start-jsk/telemba/README.md

Telemba
===================

**WARNING: This project is no longer maintained. You cannot make it work anymore without MUCH effort.**

Telemba is the world's cheapest telepresence robot. 

Telemba video (http://www.youtube.com/watch?v=4p75EE9H2MQ)

Telemba builds your Roomba and Android into a new communication
tool. If you have a Roomba and an Android tablet (or phone), Telemba
is definitely easiest and cheapest way to build your own tele-presence
robot.

Telemba is open-source and open-hardware project. It is designed as
anyone can modify it adding sensors and RC servo motors to control as
the video shows.

Please see the wiki page of telemba for how to make your own telemba.

[Telemba Wiki](https://github.com/start-jsk/telemba/wiki)

# LISENCE
* Mechanical CAD data is published under Creative Commons (BY-SA)
* Source code for PIC ADK is published under MIT License. Certain file is provided by Microchip corp.
* Sorrce code for Android app is published under ??? License (TBD).
