start-jsk/telemba/hangouts/img/connect-button.png

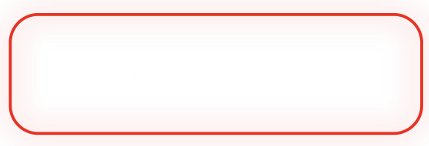
hangouts/img/connect-button.png
