start-jsk/telemba/hangouts/img/telemba_connect.png

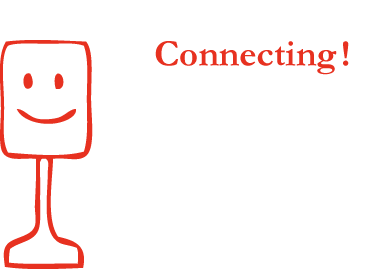
hangouts/img/telemba_connect.png
