start-jsk/telemba/hangouts/img/telemba_missing.png

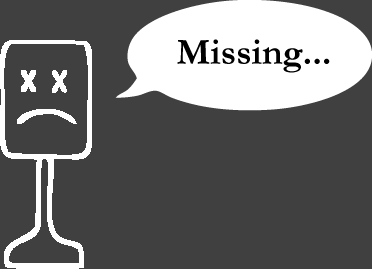
hangouts/img/telemba_missing.png
