start-jsk/telemba/hangouts/img/telemba_without_battery.png

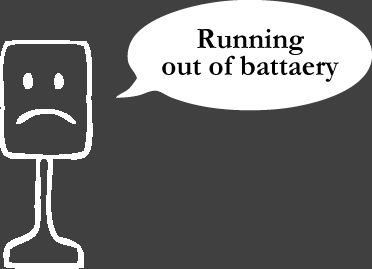
hangouts/img/telemba_without_battery.png
