start-jsk/telemba/mechanical/Telemba-012/Telemba-012_PartsList.pdf

Mechanical System | Telemba-012

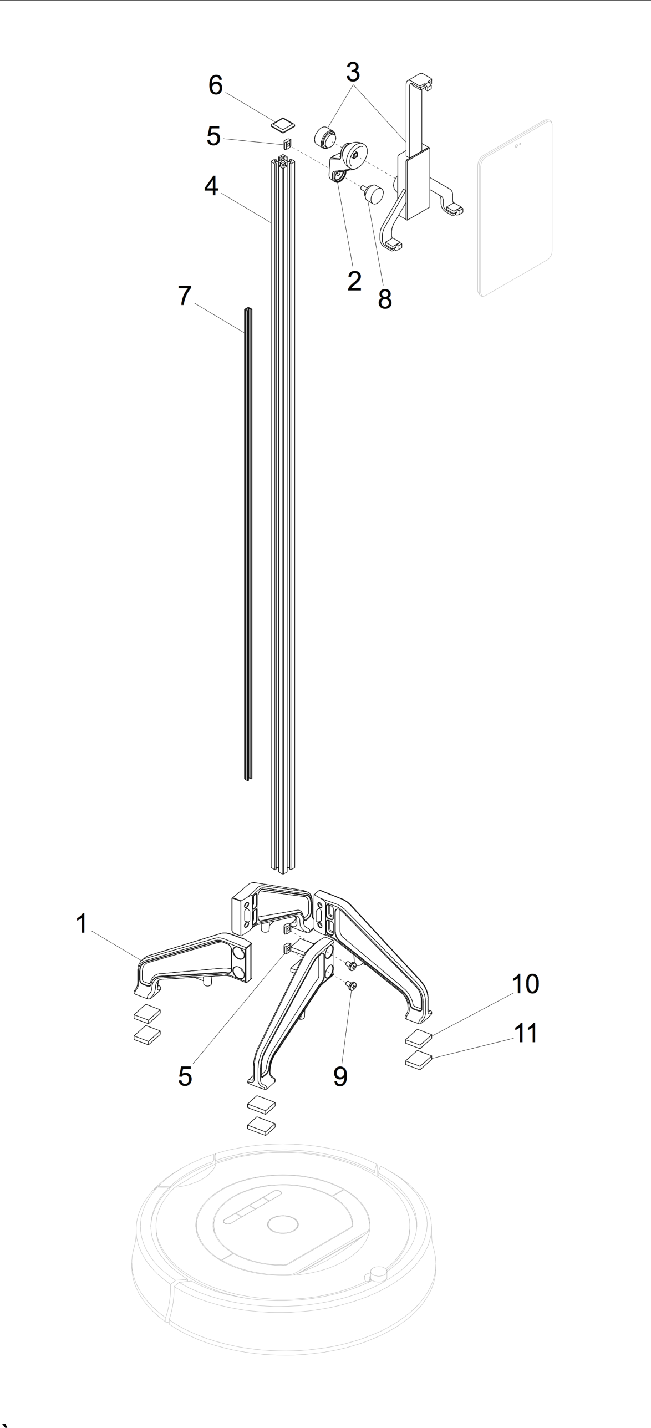
[picture p5: figure]

`

No. | Part Number | Part Name | Qty | Maker | Remarks
1 | 50000-TLMB-0000 | Leg, Base | 4 | | Telemba-012_3DPrinter.stl / igs
2 | 50001-TLMB-0000 | Bracket, Tablet Holder | 1 | | Telemba-012_3DPrinter.stl / igs
3 | | Holder, Tablet | 1
4 | SFF-204 L=1000 | Frame, Standard 20-20 | 1 | SUS Corp. | Length : 1000mm
5 | SFN-TX5 | T Nut, SS (M5) - Stainless | 9 | SUS Corp.
6 | SFA-009 | Cap, Frame 2020 - Black | 1 | SUS Corp.
7 | SFA-103 | Cap, Slot SS - Black | 1 | SUS Corp. | Length : 600mm
8 | No.2 M5 L12 | Bolt, Stepped Grip | 1 | Daimaru Byora
9 | M5x0.8 L8 | Bolt, Binding Head | 8
10 | MP3551J | Fastener, Dual Lock | 4 | 3M | Length : 20mm
11 | MP3552J | Fastener, Dual Lock | 4 | 3M | Length : 20mm

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
## Aug 2014 – Telemba Project

Electrical System | Telemba-012

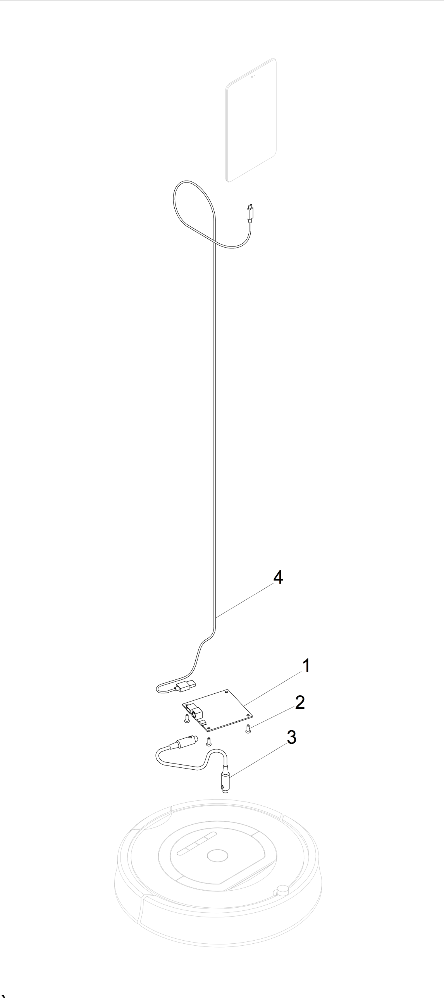
[picture p6: figure]

`

No. | Part Number | Part Name | Qty | Maker | Remarks
1 | Roombox-2.2 | Circuit | 1
2 | M3 B0 L10 | Tapping Screw, Binding Head | 4
3 | | Harness, mini-DIN 8P Straight | 1 | | Length : 400mm
4 | | Harness, USB A - micro-USB B | 1 | | Length : 1500mm

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
## Aug 2014 – Telemba Project
