start-jsk/telemba/electric/parts-v2.3.ods

パーツ番号 | 型番 | 種類 | 単価 | 単価備考 | 最安調達先 | 試作調達先 | 備考 | 在庫 | 試作調達先リンク
C1 | RD15F105Z1HH5L | 積層セラミックコンデンサ1uF(50V)5mmピッチ | 10 | 10個入り |  | 秋月 |  |  | http://akizukidenshi.com/catalog/g/gP-03093/
C2 | RD15F105Z1HH5L | 積層セラミックコンデンサ1uF(50V)5mmピッチ | 10 | 10個入り |  | 秋月 |  |  | http://akizukidenshi.com/catalog/g/gP-03093/
C3 | RD15F105Z1HH5L | 積層セラミックコンデンサ1uF(50V)5mmピッチ | 10 | 10個入り |  | 秋月 |  |  | http://akizukidenshi.com/catalog/g/gP-03093/
C4 | RD20F106Z1CH5L | 積層セラミックコンデンサ10uF(16V)5mmピッチ | 20 | 10個入り |  | 秋月 |  |  | http://akizukidenshi.com/catalog/g/gP-02184/
IC1 | PIC24FJ64GB002 | マイコン | 346 | 100個購入時 | DigiKey | DigiKey |  |  | http://www.digikey.jp/product-detail/ja/PIC24FJ64GB002-I%2FSP/PIC24FJ64GB002-I%2FSP-ND/2179121 | http://www.digikey.jp/product-detail/ja/PIC24FJ64GB002-I%2FSP/PIC24FJ64GB002-I%2FSP-ND/2179121 | http://jp.mouser.com/ProductDetail/Microchip/PIC24FJ64GB002-I-SP/
JP1 |  | ピンヘッダ5ピン |  |  |  | 秋月 |  |  | http://akizukidenshi.com/catalog/g/gC-00167/
JP2 |  | ピンヘッダ3ピン(アングル) |  |  |  | 秋月 |  |  | http://akizukidenshi.com/catalog/g/gC-01627/
JP3 |  | ピンヘッダ4ピン(アングル) |  |  |  | 秋月 |  |  | http://akizukidenshi.com/catalog/g/gC-01627/
JP4 |  | ピンヘッダ4ピン(アングル) |  |  |  | 秋月 |  |  | http://akizukidenshi.com/catalog/g/gC-01627/
JP5 |  | ピンヘッダ3ピン(アングル) |  |  |  | 秋月 |  |  | http://akizukidenshi.com/catalog/g/gC-01627/
JP6 |  | ピンヘッダ3ピン(アングル) |  |  |  | 秋月 |  |  | http://akizukidenshi.com/catalog/g/gC-01627/
JP7 |  | ピンヘッダ3ピン(アングル) |  |  |  | 秋月 |  |  | http://akizukidenshi.com/catalog/g/gC-01627/
JP8 | FH-1x14 | ピンソケット14ピン |  | 50円 |  | 秋月 | 改造用オプション |  | http://akizukidenshi.com/catalog/g/gC-00653/
JP9 | FH-1x14 | ピンソケット14ピン |  | 50円 |  | 秋月 | 改造用オプション |  | http://akizukidenshi.com/catalog/g/gC-00653/
LED1 | EGB3402S | Φ3mm LED 緑 | 5 |  |  | 秋月 |  |  | http://akizukidenshi.com/catalog/g/gI-03459/
LED2 |  | Φ3mm LED 黄 | 5 |  |  | 秋月
PWR | LT3U31P | Φ3mm LED 赤 | 5 |  |  | 秋月 |  |  | http://akizukidenshi.com/catalog/g/gI-02320/
R1 | RD25S 10K | 10kオーム ¼ W カーボン抵抗 |  |  | どこでも | 秋月 |  |  | http://akizukidenshi.com/catalog/g/gR-25103/
R2 | RD-25TJ121 | 120オーム ¼ W カーボン抵抗 |  |  | どこでも | 秋月 |  |  | http://akizukidenshi.com/catalog/g/gR-25121/
R3 | RD-25TJ121 | 120オーム ¼ W カーボン抵抗 |  |  | どこでも | 秋月 |  |  | http://akizukidenshi.com/catalog/g/gR-25121/
R4 | RD-25TJ121 | 120オーム ¼ W カーボン抵抗 |  |  | どこでも | 秋月 |  |  | http://akizukidenshi.com/catalog/g/gR-25121/
S1 | MS-12AAH1 | 電源用スライドスイッチ | 100 |  | せんごくネット | せんごくネット |  |  | http://www.sengoku.co.jp/mod/sgk_cart/detail.php?code=EEHD-0SRL | http://www.monotaro.com/k/store/MS%252D12AAH1/
S2 | DTS-6-V | タクトスイッチ | 10 |  | 秋月 | 秋月 | ユーザ入力用 | 10 | http://akizukidenshi.com/catalog/g/gP-03647/
S3 | EDS102S | DIPスイッチ | 50 |  | 秋月 | 秋月 | USB経由のダウンロード用 |  | http://akizukidenshi.com/catalog/g/gP-03141/
U1 | OKI-78SR-5/1.5-W36H-C | DCコンバータ 5V/1.5A | 433 | 100個購入時 | DigiKey | DigiKey |  |  | http://www.digikey.jp/product-detail/ja/OKI-78SR-5%2F1.5-W36H-C/811-2692-ND/3438675 | http://www.digikey.jp/product-detail/ja/OKI-78SR-5%2F1.5-W36H-C/811-2692-ND/3438675
U2 | XC6202P332TB | 3端子レギュレータ | 50 |  | 秋月 | 秋月 |  | 4 | http://akizukidenshi.com/catalog/g/gI-03421/
X1 | TCS7588-01-201 | miniDIN8ピンコネクタ | 129 | 100個購入時 | 共立エレショップ | 共立エレショップ |  | 2 | http://eleshop.jp/shop/g/g61F14E/
X2 | USB-A | USBコネクタ/Ａタイプ/メス | 50 |  | 秋月 | 秋月 |  | 2 | http://akizukidenshi.com/catalog/g/gC-00160/
X3 | UseConn C2235 | USB/mini-B | 50 | 4個セットで | 秋月 | 秋月 |  | 2 | http://akizukidenshi.com/catalog/g/gC-02235/
 |  | 合計 | 1283
