start-jsk/telemba/(threads)

Thread 9 (2015-01-19):

Telembaの使い方および改造について

rmiz, 2015-01-19:
先日、Maker Faire Tokyoにてコントロール基板をいただいた者です。
無事組みあがり、きちんと動作することが確認できました。
早速ですが、色々と改造しつつ使い倒したいと考えているのですが、そもそも機器の仕様上可能なのか、分かる範囲で結構ですので、ご教示いただけないでしょうか。

＜使い方について＞
・会場ではBluetooth接続で操縦されていましたが、やり方を教えていただけないでしょうか。
・充電ドックへの自動帰還は可能でしょうか？
・一芸として、ロボットとして移動中でも掃除できる、というようなことは可能ですか？

＜改造について＞
・コントロール基板ONの時はRoombaには充電されていないようですが、充電可能にする方法はありますか？
・Telembaの操作が個人的には難しく感じます（まっすぐに進むのが難しい）。Telembaの操作性改善のため、PC側のHangoutsアプリのUIを改造（カーソルキーで操縦など）することは可能でしょうか？
・アクチュエータを取り付けたり、外部カメラを取り付けたり・・・などということを考えているのですが、そもそもTelembaのシステムの仕組みがよく理解できていません。改造に当たって参考になる書籍やウェブサイトなどがありましたら、教えていただけないでしょうか。

以上、大変お手数ですが、よろしくお願いいたします。

longjie, 2015-01-20:
@rmiz さん、ありがたいです。取り急ぎいくつか返します。

> ・会場ではBluetooth接続で操縦されていましたが、やり方を教えていただけないでしょうか。

紛らわしかったかもしれませんが、Telembaの基板自体にはBluetooth接続の機能はありません。会場で使っていたのは拙作Friskroombaという別のモジュールです。FriskRoombaは今はもう作ってないです。僕の知ってる限り、日本で使えるRoomba用のBluetoothモジュールは無かったと思います。作ればそこそこ売れるかも？

海外では, "Rootooth"という名前の商品がSparkfunから出ています。

> ・充電ドックへの自動帰還は可能でしょうか？

現状ではサポートしていません。Roombaのコマンドに"DOCK"コマンドというのがあり、それを送るとドッキングする動作（Dockボタンをおした時と同じ)を起動できますので、追加はできると思います。

>一芸として、ロボットとして移動中でも掃除できる、というようなことは可能ですか？

これも現状は実装していませんが、RoombaのMOTOR コマンドを送ると、メインブラシ、サイドブラシ、バキュームのモータは独立にON/OFFできるようになるので、今後の追加は可能です。

>・コントロール基板ONの時はRoombaには充電されていないようですが、充電可能にする方法はありますか？

コントロール基板がONの時は、上面LEDが消灯すると思いますが、充電ドックで充電はされているはずです。また、充電ドックに刺さってるDCプラグを直接本体に指すと、コマンドを受付けなくなるのでLEDも点灯しながら充電できると思います。

ただ、電源周りの挙動は全然テストしていないので少し不安で、ルンバやAndroid端末のバッテリーを痛めてしまっても行けないと思うので、つけたまま充電はしないほうがいいと思います。

>・Telembaの操作が個人的には難しく感じます（まっすぐに進むのが難しい）。Telembaの操作性改善のため、PC側のHangoutsアプリのUIを改造（カーソルキーで操縦など）することは可能でしょうか？

キーボードでの操作は必要だと私も思うので、追加していきます。実は @s-noda さんが一度実装したはずなので、どこかにコメントアウトされてるのを入れる程度でできるかも？

> ・アクチュエータを取り付けたり、外部カメラを取り付けたり・・・などということを考えているのですが、そもそもTelembaのシステムの仕組みがよく理解できていません。改造に当たって参考になる書籍やウェブサイトなどがありましたら、教えていただけないでしょうか。

Telembaじたいの仕組みは、まだあまりかけていないのですが、Wikiに拡充したいと思っています。
回路図は[ここ](https://github.com/start-jsk/telemba/wiki/Electronics_Board_JP)にあり、試験的にラジコンサーボを動かしたりしたことはあります。

Roombaへのコマンド自体の情報は、

* [hackingroomba.com](http://hackingroomba.com/) 英語ですが元祖ハッキングサイト
* [コマンド一覧のPDF]http://irobot.lv/uploaded_files/File/iRobot_Roomba_500_Open_Interface_Spec.pdf)

等にあります。"Hacking roomba"で検索すればまだあると思いますが、残念ながら日本語ではあまり情報がないかもしれません。

出された要望については、後ほどそれぞれ新しいIssueとして立てて、順次追加していくというふうにしたいと思います。

今後ともよろしくおねがいします。

rmiz, 2015-01-20:
@longjie さん、お忙しいところ丁寧にご回答いただき、ありがとうございます。

ご回答いただいた内容について、まだ全部はフォローできておりませんが、下記部分についてもう少し質問させていただけないでしょうか。
> キーボードでの操作は必要だと私も思うので、追加していきます。実は @s-noda さんが一度実装したはずなので、どこかにコメントアウトされてるのを入れる程度でできるかも？

これはファームウェアのことでしょうか。android.cなどにRoombaへの操縦コマンド入力について記述されているのを見つけましたが、これはAndroid端末からvelocityやradiusのデータを受け取った後の処理に思われます。
Roombaへの操作入力を受け付ける部分は、Hangoutsアプリの方かなと思うのですが、この理解で正しいでしょうか。また、Hangoutsアプリについてはソースコードが公開されていないようですが、公開していただいたり、改造させていただくことなどは可能でしょうか？

longjie, 2015-01-21:
おっしゃるとおり、ファームウェアではなく、Hangoutsアプリの話です。アプリはここに公開されています。
かなりプロトタイプ的なコードですが…

https://github.com/start-jsk/telemba/tree/master/hangouts

このあたりにキーボード操作の名残があります。
https://github.com/start-jsk/telemba/blob/master/hangouts/script/roombox-controller.js

取り急ぎ。

rmiz, 2015-01-21:
@longjie さん、お忙しいところありがとうございます。
試してみたいと思います。

Thread 10 (2015-01-26):

Communication Problems with Telemba and Google Hangouts

jngeo, 2015-01-26:
To whom it may concern,

I recently tried to use Telemba with my Nexus 7 (via Google Hangouts).
After following all instructions from the wiki page, it seems that I can see the
battery status of Android and Roomba on the telemba app on Hangout Event.
But I cannot seem to control Roomba (not moving) and the connection status is always
"Connecting".

I attached here some images of the my device status and environment.

Also, when I connect the DIN pin from the Board to Roomba (model 500),
the Roomba "POWER" yellow light is turned off but the board LED is turned on.
Is this a normal occurence ?

Without connecting to the board, Romba is working fine independently on its own.
My Nexus 7 has Android version 4.4.3  and I downloaded the latest TelembaController App.

I hope that you could give me some advice on how to troubleshoot this problem.
Thank you for your time and help. Looking forward to hearing from you.

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

longjie, 2015-01-26:
Hi,

I see, please try the Request button before you command roomba. It is new
feature we are testing to prevent conflict of multiple ownership. The one
who push the button can get the control right for a minuite. I'm afraid it
is not documented yet, sorry.

2015 $BG/ (B1 $B7n (B27 $BF|2PMKF|!" (Bjngeo<notifications@github.com> $B$5$s$O=q$-$^$7$? (B:

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

--
Ryosuke "Ron" Tajima

jngeo, 2015-01-27:
Hi @longjie ,

Great ! It is now working !
Thank you for the help.

All the best,
Jim
