start-jsk/telemba/electric/schematics-v2.3.pdf

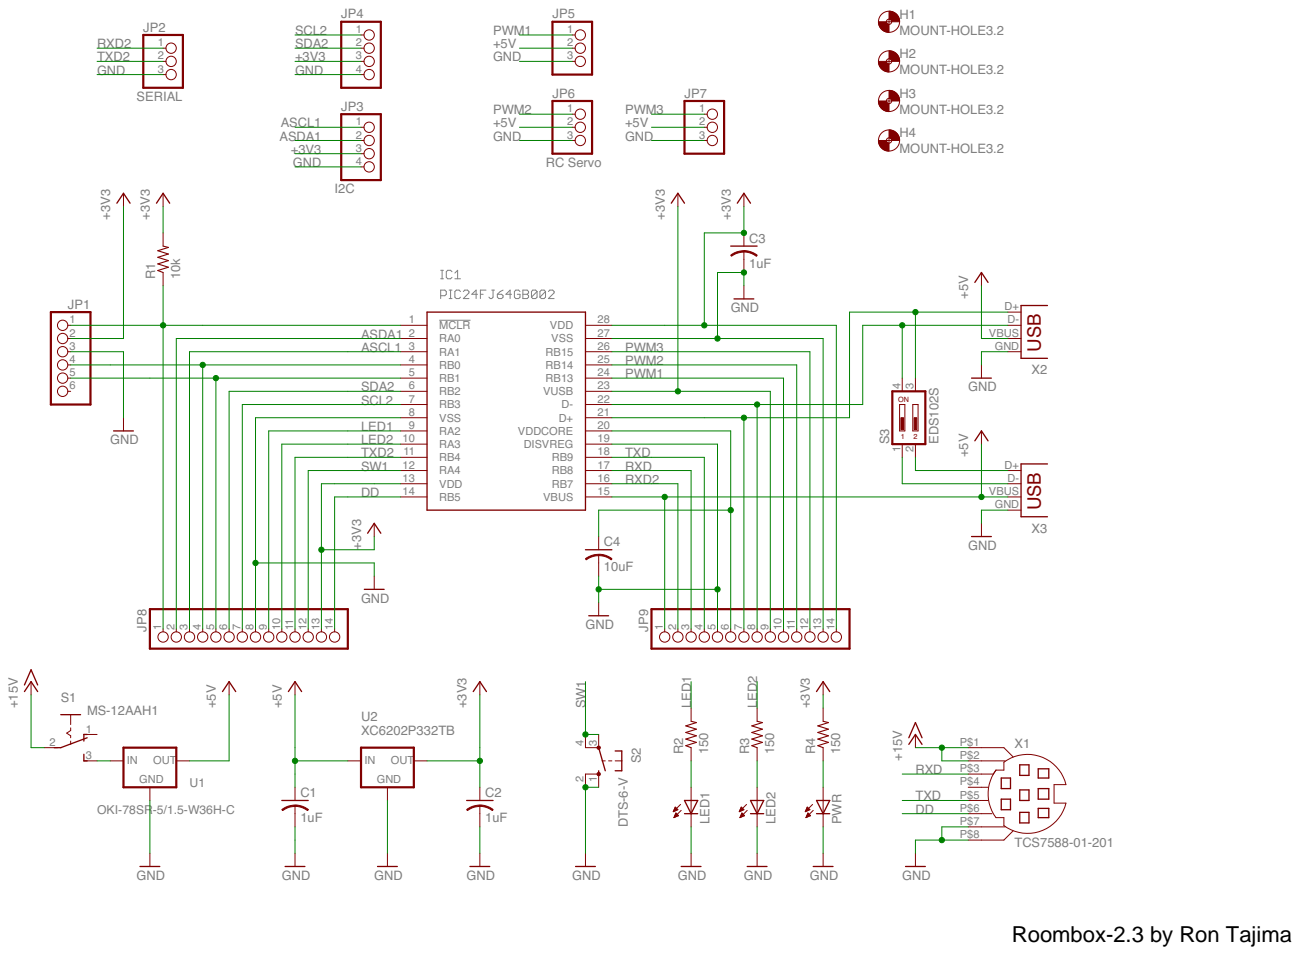
[picture p7: page 1]

LED1 | 20 D+
LED2 | 19 VDDCORE
