start-jsk/telemba/electric/35100-TLMB-0000_Harness_miniDIN-8P.pdf

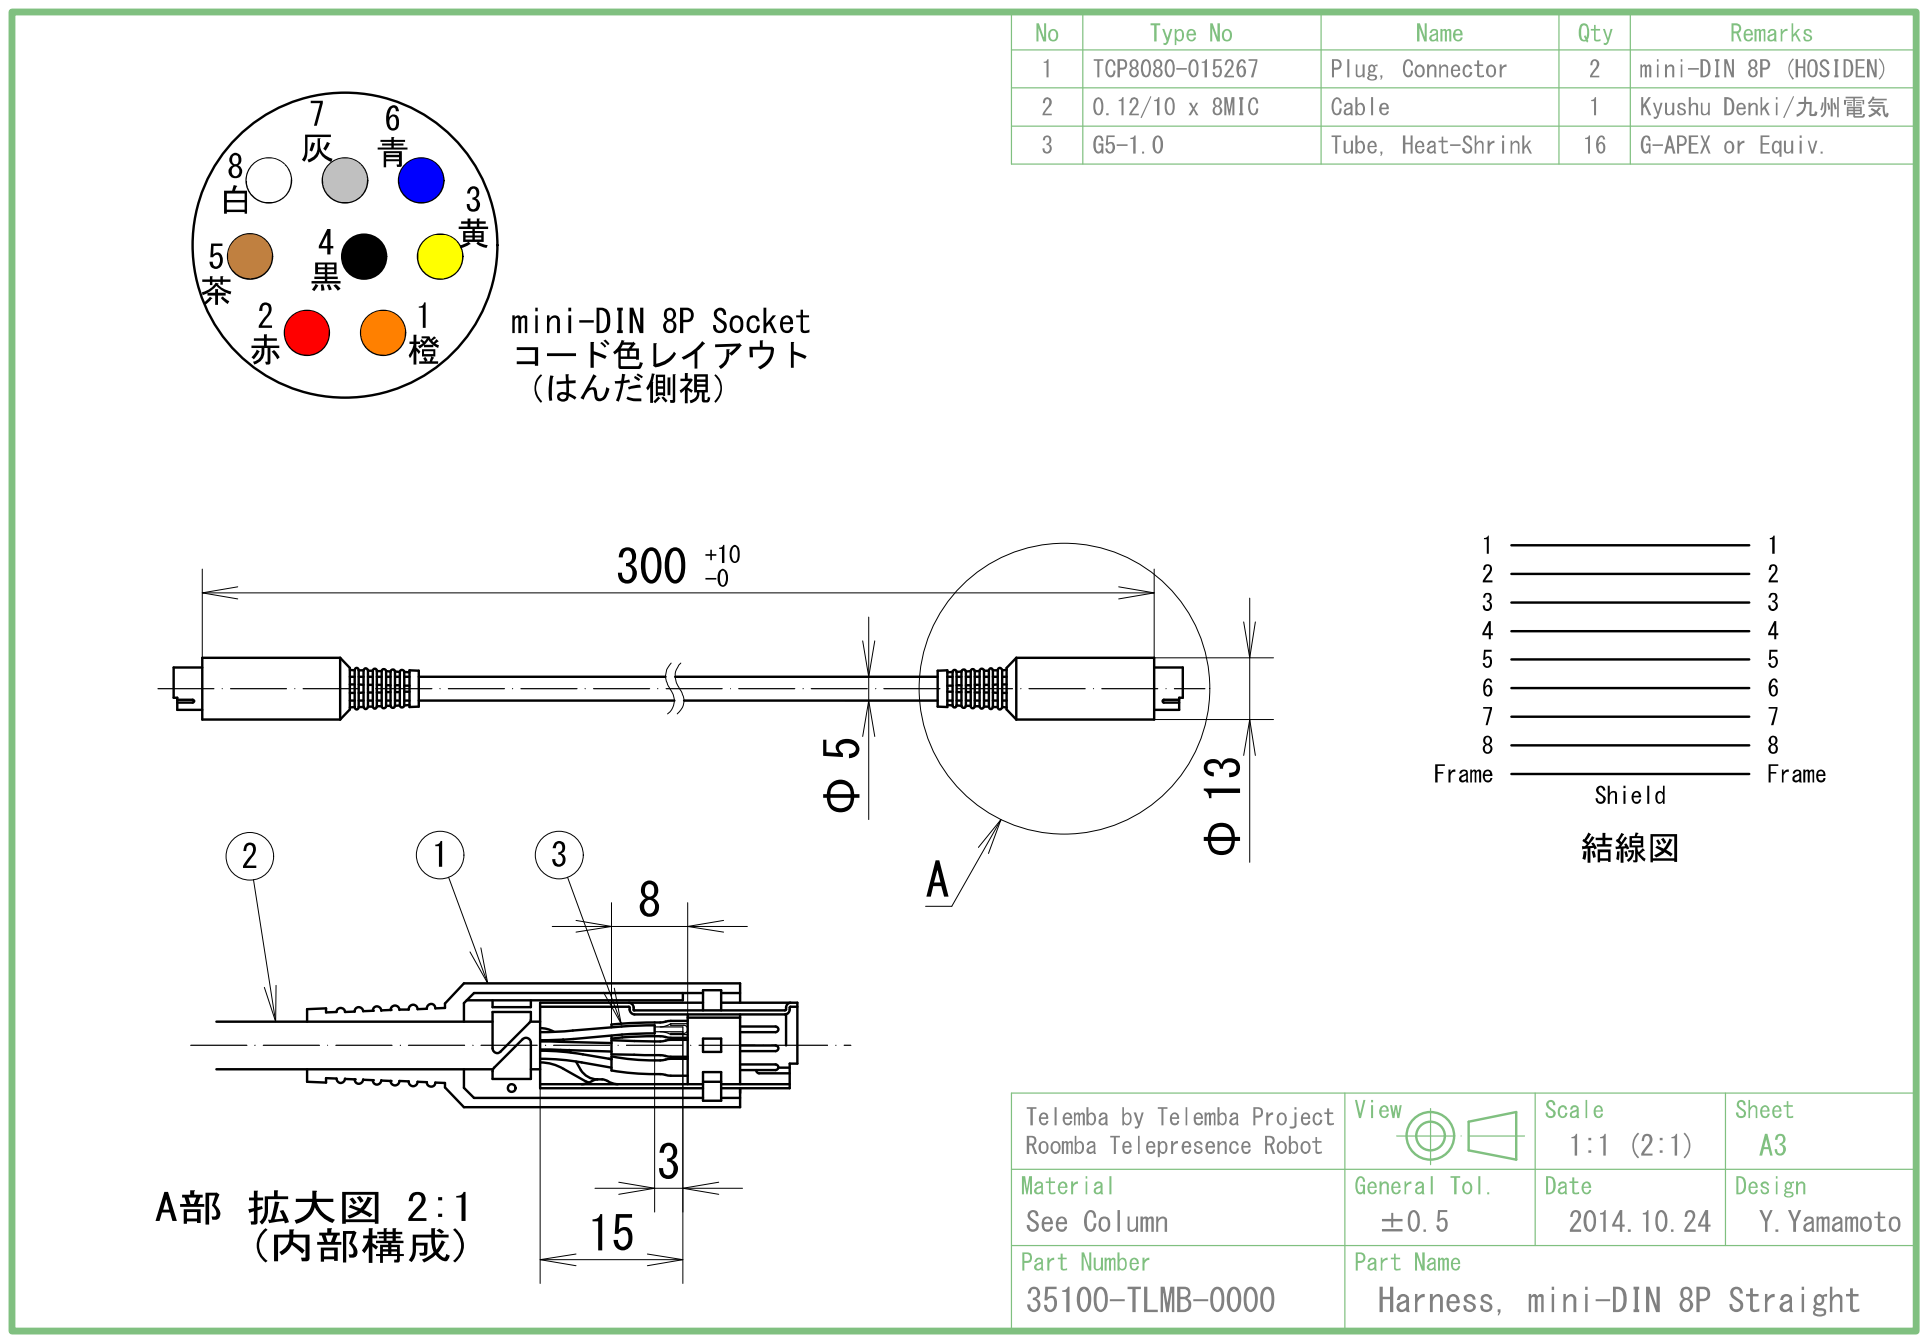
[picture p8: page 1]
