start-jsk/telemba/firmware/application/uart2.c

/*

  UART2 Driver File for PIC24.

  ********************************************************************************
  FileName:        uart2.c
  Dependencies:    HardwareProfile.h
  Processor:       PIC24
  Compiler:        MPLAB C30
  Linker:          MPLAB LINK30
  Company:         Microchip Technology Incorporated

  Author                Date      Comment
  ~~~~~~~~~~~~~~~~~~~~~~~~~~~~~~~~~~~~~~~~~~~~~~~~~~~~~~~~~~~~~~~~~~~~~~~~~~~~~~~~
  KO                 12-Feb-2008  Modified to use HardwareProfile.h
  KO                 11-Oct-2006  v1.0
  Anton Alkhimenok   18-Oct-2005
  Anton Alkhimenok   17-Feb-2009  Added UART2Char2Hex(), UART2Hex2Char(), 
  UART2ClearError(), UART2DataReceived()
  PAT				   27-Jan-2010  Added UART2GetBaudError() for dynamic checking
  of baud rate percentage error.

  ********************************************************************************
  Software License Agreement

  Microchip Technology Inc. ("Microchip") licenses to you the right to use, copy,
  modify and distribute the software - including source code - only for use with
  Microchip microcontrollers or Microchip digital signal controllers; provided
  that no open source or free software is incorporated into the Source Code
  without Microchip痴 prior written consent in each instance.

  The software is owned by Microchip and its licensors, and is protected under
  applicable copyright laws.  All rights reserved.

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
  ********************************************************************************
  */

#include "Compiler.h"
#include "HardwareProfile.h"
#include "uart2.h"

//******************************************************************************
// Constants
//******************************************************************************

//U2BRG register value and baudrate mistake calculation

#if defined (__C30__)
#if defined (__dsPIC33E__) || defined (__PIC24E__)
#define BAUDRATEREG2        (((GetPeripheralClock())/(BRG_DIV2 * BAUDRATE2)) - 1)
#else
#define BAUDRATEREG2        (((GetSystemClock()/2)+(BRG_DIV2/2*BAUDRATE2))/BRG_DIV2/BAUDRATE2-1)
#endif
#elif defined (__PIC32MX__)
#define BAUDRATEREG2        ((GetPeripheralClock()+(BRG_DIV2/2*BAUDRATE2))/BRG_DIV2/BAUDRATE2-1)
#else
#error Cannot calculate BRG value
#endif    

#if defined (__C30__)
#if defined (__dsPIC33E__)|| defined (__PIC24E__)
#define BAUD_ACTUAL         ((GetPeripheralClock())/(BRG_DIV2 * (BAUDRATEREG2+1)))
#else
#define BAUD_ACTUAL         ((GetSystemClock()/2)/BRG_DIV2/(BAUDRATEREG2+1))
#endif
#elif defined (__PIC32MX__)
#define BAUD_ACTUAL         (GetPeripheralClock()/BRG_DIV2/(BAUDRATEREG2+1))
#else
#error Cannot calculate actual baud rate
#endif 

#define BAUD_ERROR              ((BAUD_ACTUAL > BAUDRATE2) ? BAUD_ACTUAL-BAUDRATE2 : BAUDRATE2-BAUD_ACTUAL)
#define BAUD_ERROR_PERCENT      ((BAUD_ERROR*100+BAUDRATE2/2)/BAUDRATE2)
	
#if defined (__C30__)

#if (BAUD_ERROR_PERCENT > 3)
#error UART frequency error is worse than 3%
#elif (BAUD_ERROR_PERCENT > 2)
#warning UART frequency error is worse than 2%
#endif

#endif // #if defined (__C30__)

/*******************************************************************************
Function: UART2GetBaudError()

Precondition:
    None.

Overview:
    This routine checks the UART baud rate error percentage and returns it.

Input: None.

Output: Returns the baud rate error in percent.

*******************************************************************************/
char UART2GetBaudError()
{
    unsigned int errorPercent = 0;

    errorPercent = ((BAUD_ERROR*100+BAUDRATE2/2)/BAUDRATE2);
    return (char)errorPercent;
}


/*******************************************************************************
Function: UART2GetChar()

Precondition:
    UART2Init must be called prior to calling this routine.

Overview:
    This routine waits for a byte to be received.  It then returns that byte.

Input: None.

Output: Byte received.

*******************************************************************************/
char UART2GetChar()
{
    char Temp;

    while(IFS1bits.U2RXIF == 0);

    Temp = U2RXREG;
    IFS1bits.U2RXIF = 0;
    return Temp;
}

/*******************************************************************************
Function: UART2Init()

Precondition: None.

Overview:
    This routine sets up the UART2 module.

Input: None.

Output: None.

Notes:
    Allow the peripheral to set the I/O pin directions.  If we set the TRIS
    bits manually, then when we disable the UART, the shape of the stop bit
    changes, and some terminal programs have problems.
*******************************************************************************/
void UART2Init()
{
    U2BRG = BAUDRATEREG2;
    U2MODE = 0;
    U2MODEbits.BRGH = BRGH2;
    U2STA = 0;
    U2MODEbits.UARTEN = 1;
    U2STAbits.UTXEN = 1;
    IFS1bits.U2RXIF = 0;
    IFS1bits.U2TXIF = 0;
    
#if defined (__PIC32MX__)
    U2STAbits.URXEN = 1;
#endif
}

/*******************************************************************************
Function: UART2IsPressed()

Precondition:
UART2Init must be called prior to calling this routine.

Overview:
This routine checks to see if there is a new byte in UART reception buffer.

Input: None.

Output:
0 : No new data received.
1 : Data is in the receive buffer

*******************************************************************************/
char UART2IsPressed()
{
    if(IFS1bits.U2RXIF == 1)
	return 1;
    return 0;
}

/*******************************************************************************
Function: UART2PrintString( char *str )

Precondition:
    UART2Init must be called prior to calling this routine.

Overview:
    This function prints a string of characters to the UART.

Input: Pointer to a null terminated character string.

Output: None.

*******************************************************************************/
void UART2PrintString( char *str )
{
    unsigned char c;

    while( (c = *str++) )
	UART2PutChar(c);
}

/*******************************************************************************
Function: UART2PutChar( char ch )

Precondition:
    UART2Init must be called prior to calling this routine.

Overview:
    This routine writes a character to the transmit FIFO, and then waits for the
    transmit FIFO to be empty.

Input: Byte to be sent.

Output: None.

*******************************************************************************/
void UART2PutChar( char ch )
{
    U2TXREG = ch;
#if !defined(__PIC32MX__)
    Nop();
    Nop();
#endif
    while(U2STAbits.TRMT == 0);
}

/*******************************************************************************
Function: UART2PutDec(unsigned char dec)

Precondition:
    UART2Init must be called prior to calling this routine.

Overview:
    This function converts decimal data into a string and outputs it to UART.

Input: Binary data.

Output: None.

*******************************************************************************/
void  UART2PutDec(unsigned char dec)
{
    unsigned char res;
    unsigned char printed_already = 0;

    res = dec;

    if (res/100)
	{
	    UART2PutChar( res/100 + '0' );
	    printed_already = 1;
	}
    res = res - (res/100)*100;

    if ((res/10) || (printed_already == 1))
	{
	    UART2PutChar( res/10 + '0' );
	}
    res = res - (res/10)*10;

    UART2PutChar( res + '0' );
}

/*******************************************************************************
Function: UART2PutHex

Precondition:
    UART2Init must be called prior to calling this routine.

Overview:
    This function converts hex data into a string and outputs it to UART.

Input: Binary data.

Output: None.

*******************************************************************************/

const unsigned char CharacterArray[]={'0','1','2','3','4','5','6','7','8','9','A','B','C','D','E','F'};

void UART2PutHex( int toPrint )
{
    int printVar;

    printVar = toPrint;
    toPrint = (toPrint>>4) & 0x0F;
    UART2PutChar( CharacterArray[toPrint] );

    toPrint = printVar & 0x0F;
    UART2PutChar( CharacterArray[toPrint] );

    return;
}

/*******************************************************************************
Function: UART2PutHexWord(unsigned int toPrint)

Precondition:
    UART2Init must be called prior to calling this routine.

Overview:
    This function converts hex data into a string and outputs it to UART.

Input: Binary data.

Output: None.

*******************************************************************************/
#if defined( __C30__ ) || defined( __PIC32MX__ )
void UART2PutHexWord( unsigned int toPrint )
{
    unsigned int printVar;

    printVar = (toPrint>>12) & 0x0F;
    UART2PutChar( CharacterArray[printVar] );

    printVar = (toPrint>>8) & 0x0F;
    UART2PutChar( CharacterArray[printVar] );

    printVar = (toPrint>>4) & 0x0F;
    UART2PutChar( CharacterArray[printVar] );

    printVar = toPrint & 0x0F;
    UART2PutChar( CharacterArray[printVar] );

    return;
}

void UART2PutHexDWord( unsigned long toPrint )
{
    unsigned long printVar;

    printVar = (toPrint>>28) & 0x0F;
    UART2PutChar( CharacterArray[printVar] );

    printVar = (toPrint>>24) & 0x0F;
    UART2PutChar( CharacterArray[printVar] );

    printVar = (toPrint>>20) & 0x0F;
    UART2PutChar( CharacterArray[printVar] );

    printVar = (toPrint>>16) & 0x0F;
    UART2PutChar( CharacterArray[printVar] );

    printVar = (toPrint>>12) & 0x0F;
    UART2PutChar( CharacterArray[printVar] );

    printVar = (toPrint>>8) & 0x0F;
    UART2PutChar( CharacterArray[printVar] );

    printVar = (toPrint>>4) & 0x0F;
    UART2PutChar( CharacterArray[printVar] );

    printVar = toPrint & 0x0F;
    UART2PutChar( CharacterArray[printVar] );

    return;
}

#endif

/*********************************************************************
Function: char UART2Char2Hex(char ch)

PreCondition: none

Input: ASCII to be converted

Output: number

Side Effects: none

Overview: converts ASCII coded digit into number

Note: none

********************************************************************/
char UART2Char2Hex(char ch){
    // Wrong char
    if(ch > 102)
	return 0;  
  
    // From a to f     
    if(ch > 96)
	return (ch-87);
    
    // Wrong char    
    if(ch > 70)
	return 0;
  
    // From A to F    
    if(ch > 64)
	return (ch-55);

    // Wrong char  
    if(ch > 57)
	return 0;
  
    // From 0 - 9
    if(ch > 47)
	return(ch-48);
    else
	// Wrong char
	return 0;
}

/*********************************************************************
Function: char UART2Hex2Char(char hex)

PreCondition: none

Input: number

Output: ASCII code

Side Effects: none

Overview: converts low nibble into ASCII coded digit

Note: none

********************************************************************/
char UART2Hex2Char(char hex){
    char h;
    h = hex&0x0f;
    // From 0xa to 0xf
    if(h>9)
	return (h+55);
    else
	return (h+48);
}

/*********************************************************************
Function: void UART2ClrError(void)

PreCondition: none

Input: none

Output: character received

Side Effects: none

Overview: wait for character

Note: none

********************************************************************/
void UART2ClrError(void){
    // Clear error flag
    if(U2STAbits.OERR)
	U2STAbits.OERR = 0;
}

static char uart2_recv_buff[256];
static int uart2_recv_head;
static int uart2_recv_tail;

/**
 * 受信割り込みハンドラ
 */
void __attribute__((__interrupt__,no_auto_psv)) _U2RXInterrupt(void)
{
    /* 1byte受信 */
    uart2_recv_buff[uart2_recv_tail] = U2RXREG;
    uart2_recv_tail = (uart2_recv_tail + 1) % sizeof(uart2_recv_buff);
    IFS1bits.U2RXIF = 0;
}

/**
 * バッファの受信サイズを返す
 */
int uart2_recv_get_size (void)
{
    return (uart2_recv_tail - uart2_recv_head) % sizeof(uart2_recv_buff);
}

/**
 * バッファからデータを取得
 */
int uart2_recv_get_data (char *data, int size)
{
    int i;
    if (size > sizeof(uart2_recv_buff)) {
	size = sizeof(uart2_recv_buff);
    }
    /* 受信割り込みの禁止 */
    IEC1bits.U2RXIE=0;
    if (uart2_recv_get_size() < size) {
	size = uart2_recv_get_size();
    }
    for (i=0; i<size; i++) {
	data[i] = uart2_recv_buff[uart2_recv_head];
	uart2_recv_head = (uart2_recv_head + 1) % sizeof(uart2_recv_buff);
    }
    /* 受信割り込みの許可 */
    IEC1bits.U2RXIE=1;
    return size;
}

/**
 * バッファからデータを取得
 */
char uart2_recv_get_char (void)
{
    char c;
    /* 受信割り込みの禁止 */
    IEC1bits.U2RXIE=0;
    if (uart2_recv_get_size() == 0) {
	/* 受信割り込みの許可 */
	IEC1bits.U2RXIE=1;
	return -1;
    }
    c = uart2_recv_buff[uart2_recv_head];
    uart2_recv_head = (uart2_recv_head + 1) % sizeof(uart2_recv_buff);
    /* 受信割り込みの許可 */
    IEC1bits.U2RXIE=1;
    return c;
}

/**
 * 送信バッファ関連
 */
static unsigned char uart2_send_buff[256];
static int uart2_send_head;
static int uart2_send_tail;

/**
 * 送信割り込みハンドラ
 */
void __attribute__((__interrupt__,no_auto_psv)) _U2TXInterrupt(void)
{
    /* FIFOが空の場合 */
    if (uart2_send_head == uart2_send_tail) {
        IFS1bits.U2TXIF = 0;
        return;
    }
    /* 1byte送信 */
    U2TXREG = uart2_send_buff[uart2_send_tail];
    uart2_send_tail = (uart2_send_tail + 1) % sizeof(uart2_send_buff);
    IFS1bits.U2TXIF = 0;
}

#if 0
/**
 * 送信バッファにデータを追加
 */
int uart2_send_data (unsigned char *data, int size)
{
    int i;
    if (size > sizeof(uart2_send_buff)) {
	size = sizeof(uart2_send_buff);
    }
    /* 送信割り込みの禁止 */
    IEC1bits.U2TXIE=0;
    for (i=0; i<size; i++) {
	uart2_send_buff[uart2_send_head] = data[i];
	uart2_send_head = (uart2_send_head + 1) % sizeof(uart2_send_buff);
    }
    /* 送信割り込みの許可 */
    IEC1bits.U2TXIE=1;
    return size;
}
#endif
int uart2_send_data (unsigned char *data, int size)
{
    int i;
    for (i=0; i<size; i++) {
        UART2PutChar (data[i]);
    }
}
