start-jsk/telemba/(commit log)

2013-12-26 add servo function. change timer period.
    add a simple ui to control RC servo.
2013-12-26 add motor inputs
2014-01-23 add android's battery info.
2014-03-30 change layout, login ui move abave camera
2014-04-16 update roomba image and connect button image
2014-04-22 resize roomba image and velocity x2
2014-04-22 add image files for battery progress bar
2014-04-22 update layout for battery progress
2014-04-22 telemba log move to the head of camera image
2014-04-22 fix velocity of roomba
2014-04-30 fix canvas size, and add bgEl for drawgin percentage of battery
2014-04-30 add android battery progress element
2014-04-30 add android battery progress
2014-05-01 add roomba connection check thread, 3000 msec no-message = lost connect
2014-05-21 所有者の切り替えに対応させたが、なぜかMQTTに接続するとできなくなる。
    Requestボタンを押すと、所有権を取得。
    Releaseボタンを押すと、所有権を解放。
    いちど所有権を取得すると、1分間は他の人が所有権をとれない。
    MQTTにログインして接続するまではちゃんと動く。接続するとなぜかgapi.hangout.data関連が正しくうごいていないように思える。
2014-05-27 change skip condition of sending velocitu command, skip oinly zero velociry
2014-05-29 Add feature of ownership control. Bug fix of mqttws31.js
    - 制御権のrequest/releaseボタンを追加し、動作を確認
    - mqttws31.jsにグローバル変数を使うバグがあった
2014-07-14 add schematics PDF file.
    - This schematics is the version before Kickstarter.
    - All of the function is not yet tested. We need new firmware to develop.
2014-07-14 add mechanical/Telemba/Telemaba-012_3DPrinter.stl and .igs files
2014-08-17 Mod the size of the screws for the circuit
2014-08-26 add v2.3 schematics and parts list.
    [parts-v2.3.ods]
